VinceGHER/Embedded-Systems/README.md

# Embedded-Systems

The objective of this project is to design a custom master interface for Avalon bus that allow to take
pictures from a camera interface and save it to a specific address of memory. This sub-component is
part of a bigger system, composed of a camera and a LCD display, with the objective of implementing a
real-time camera system, which continuously takes and displays images.

Here is a overview of the system.

overview

Here is a snapchot of our camera.

Final_result

You can find the complete description of the project in the file "Report.pdf".

This project was realised in the scope of the "Embedded Systems" class thaught by Beuchat René.
